eSpark-Backup/flst/Deliverables/Renderings/3D_Top_view.PNG

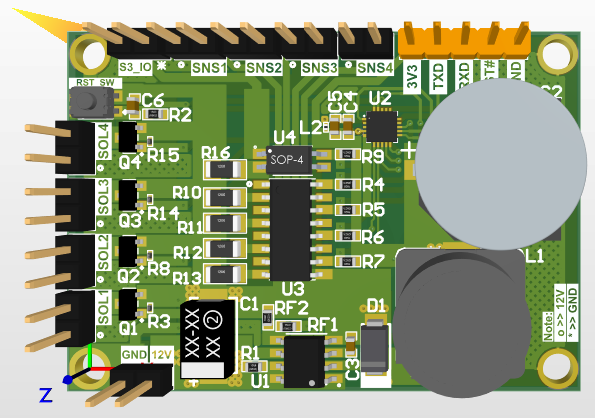
Deliverables/Renderings/3D_Top_view.PNG
