eSpark-Backup/flst/Deliverables/Renderings/3D_Bottom_view.PNG

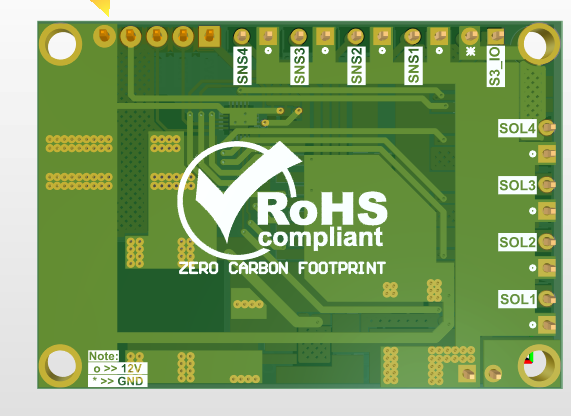
Deliverables/Renderings/3D_Bottom_view.PNG
