eSpark-Backup/flst/Design-Files/Junction_Box.html

Altium customize

# Board Information Report

Date: | | 2/23/2023
Time: | | 10:07:56 PM
Elapsed Time: | | 00:00:00
Filename: | | C:\Users\XPENDER\Documents\GitHub\flst\Design-Files\Junction_Box.PcbDoc
Units: | | mmmils

## Contents

Contents

Board Specification

General

Routing

Routing Information

Layer Information

Layer Information

Drill Pairs

Board Holes

Non-Plated Hole Size

Plated Hole Size

## Board Specification

General
Board Size | 2005mils x 1405mils
Components on board | 47

Back to top

## Routing

Routing Information
Routing completion | 100.00%
Connections | 107
Connections routed | 107
Connections remaining | 0

Back to top

## Layer Information

Layer | Arcs | Pads | Vias | Tracks | Texts | Fills | Regions | ComponentBodies
Top Layer | 0 | 119 | 0 | 140 | 0 | 48 | 0 | 0
Bottom Layer | 0 | 0 | 0 | 53 | 0 | 14 | 0 | 0
Dimension | 0 | 0 | 0 | 16 | 2 | 0 | 0 | 47
Board Outline | 0 | 0 | 0 | 4 | 0 | 0 | 0 | 0
Multi-Layer | 0 | 29 | 38 | 0 | 0 | 0 | 1 | 0
Top Paste | 0 | 0 | 0 | 0 | 0 | 0 | 0 | 0
Top Overlay | 21 | 0 | 0 | 211 | 111 | 3 | 0 | 0
Top Solder | 0 | 0 | 0 | 0 | 0 | 0 | 0 | 0
Bottom Solder | 0 | 0 | 0 | 0 | 0 | 0 | 0 | 0
Bottom Overlay | 0 | 0 | 0 | 0 | 16 | 0 | 0 | 0
Bottom Paste | 0 | 0 | 0 | 0 | 0 | 0 | 0 | 0
Drill Guide | 0 | 0 | 0 | 0 | 0 | 0 | 0 | 0
Keep-Out Layer | 0 | 0 | 0 | 0 | 0 | 0 | 0 | 0
Drill Drawing | 0 | 0 | 0 | 0 | 0 | 0 | 0 | 0
Total | 21 | 148 | 38 | 424 | 129 | 65 | 1 | 47

Back to top

Drill Pairs | Vias
Total | 0

Back to top

## Board Holes

Non-Plated Hole Size | Pads | Vias
0mils | 0 | 0
Total | 0 | 0

Back to top

Plated Hole Size | Pads | Vias
0mils | 0 | 0
11.811mils | 0 | 0
35.433mils | 0 | 0
40.158mils | 0 | 0
118.11mils | 0 | 0
Total | 0 | 0

Back to top
