eSpark-Backup/flst/Deliverables/Renderings/2D_Bottom_view.PNG

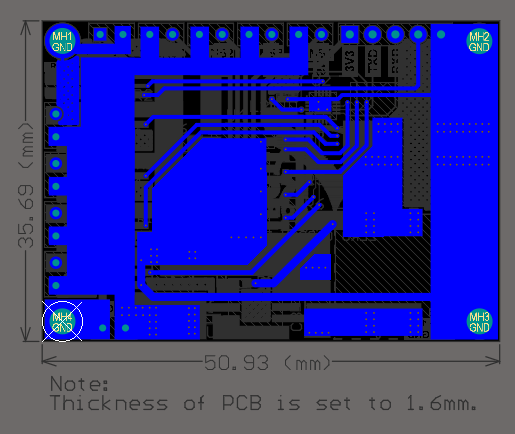
Deliverables/Renderings/2D_Bottom_view.PNG
