eSpark-Backup/flst/Deliverables/Renderings/2D_Top_view.PNG

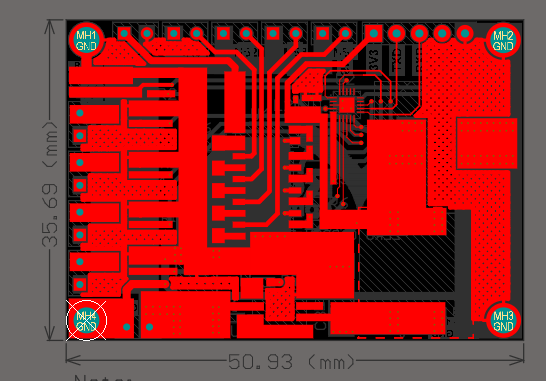
Deliverables/Renderings/2D_Top_view.PNG
