eSpark-Backup/flst/Deliverables/Renderings/3D_Isometric_view.PNG

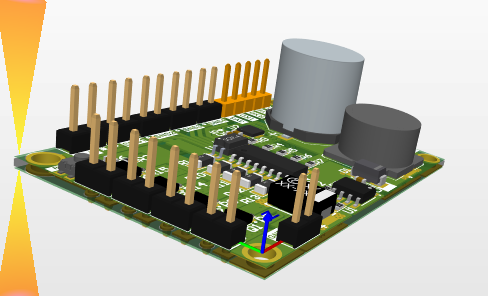
Deliverables/Renderings/3D_Isometric_view.PNG
