eSpark-Backup/flst/PCB Review/Layer Stackup.PNG

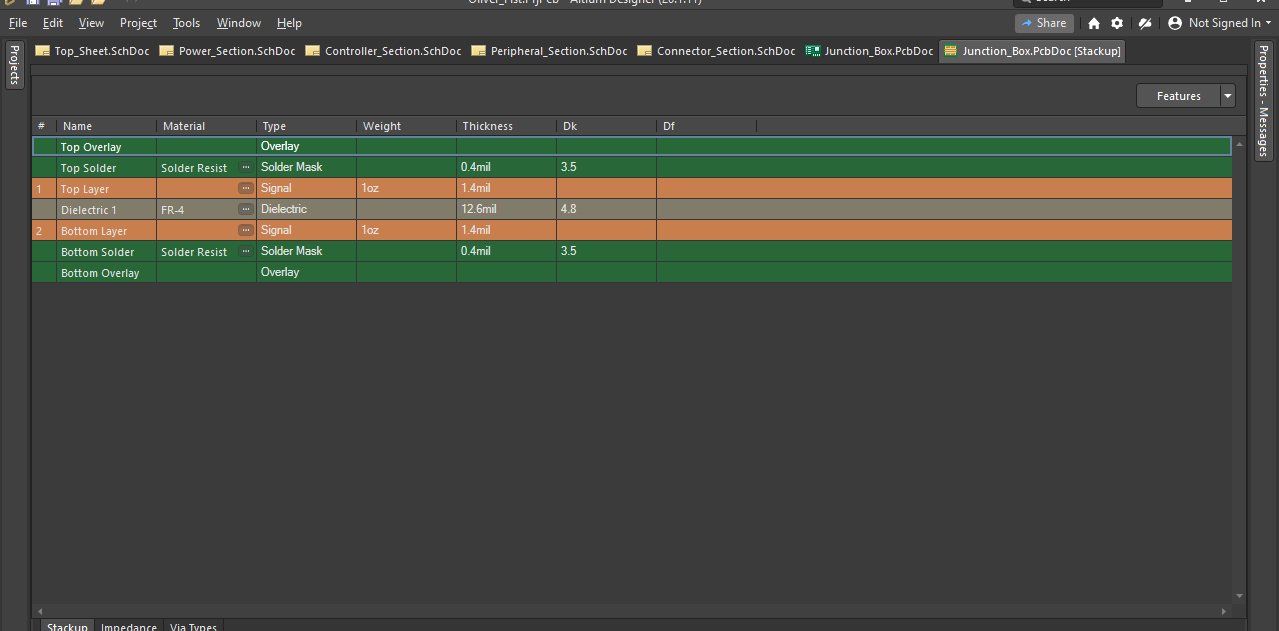
PCB Review/Layer Stackup.PNG
