eSpark-Backup/flst/Deliverables/BOM/eSpark_BOM_Oliver_Flst.xlsx

 |  | Component list |  | Bill of Materials for Project [Oliver_Flst]
 |  | Source Data From: |  | [Oliver_Flst]
 |  | Project: |  | [Oliver_Flst]
 |  | Variant: |  | None
# | Item Type | Designator | Description | Footprint | Manufacturer Part Number | Manufacturer | Alternate Part Number | LCSC/Part Number | Value | Quantity | Quantity (5 Boards) | MOQ (5 Boards) | Links | Unit Cost (5 Boards) | Total Cost (5 Boards) | Remarks | Reviewer Remarks
1 | Capacitor | C1 | CAP TANT 100UF 20% 25V 2917 | CAP- 2917 | TAJE107M025RNJ | Kyocera AVX | ----------- | C7230 | 100uF | 1 | 5 | 6 | LCSC (https://lcsc.com/product-detail/Tantalum-Capacitors_AVX-TAJE107M025RNJ_C7230.html) | $1.4064 | $8.44
2 | Capacitor | C2 | 470uF ±20% 50V 12.5mm 13.5mm 1000hrs 105℃ -40℃~+105℃ SMD,12.5x13.5mm Aluminum Electrolytic Capacitors - SMD RoHS | Custom | VKMD1001J101MV | Changzhou Huawei Elec | ----------- | C191227 | 470uF | 1 | 5 | 6 | LCSC (https://lcsc.com/product-detail/Aluminum-Electrolytic-Capacitors-SMD_Changzhou-Huawei-Elec-VT1H471MI135000CE0_C191227.html) | $0.3739 | $2.24
3 | Capacitor | C3 | CAP CER 470pF 10% X7R 50V 0603 SMD | Cap0603 | CC0603KRX7R9BB471 | Yageo | ----------- | C107092 | 470pF | 1 | 5 | 100 | LCSC (https://lcsc.com/product-detail/Multilayer-Ceramic-Capacitors-MLCC-SMD-SMT_YAGEO-CC0603KRX7R9BB471_C107092.html) | $0.0026 | $0.26
4 | Capacitor | C4, C6 | CAP CER 0.1UF 50V Y5V 0603 | Cap0603 | CC0603ZRY5V9BB104 | Yageo | ----------- | C106221 | 0.1uF | 2 | 10 | 100 | LCSC (https://lcsc.com/product-detail/Multilayer-Ceramic-Capacitors-MLCC-SMD-SMT_YAGEO-CC0603ZRY5V9BB104_C106221.html) | $0.0028 | $0.28
5 | Capacitor | C5 | CAP CER 1UF 25V X5R 0603 | Cap0603 | CC0603KRX5R8BB105 | Yageo | ----------- | C14664 | 1uF | 1 | 5 | 100 | LCSC (https://lcsc.com/product-detail/Multilayer-Ceramic-Capacitors-MLCC-SMD-SMT_YAGEO-CC0603KRX5R8BB105_C14664.html) | $0.0051 | $0.51
6 | Diode | D1 | 40V 500mV@2A 2A SMA(DO-214AC) Schottky Barrier Diodes (SBD) ROHS | SMA | SS24A | Yangzhou | ----------- | C211773 | -------- | 1 | 5 | 10 | LCSC (https://lcsc.com/product-detail/Schottky-Barrier-Diodes-SBD_Yangzhou-Yangjie-Elec-Tech-SS24A_C211773.html) | $0.0399 | $0.40
7 | Header | J1 | Pin Header 5 1 right-angle | HDR1X5 | PZ254V-11-05P | XFCN | ----------- | C492404 | ------- | 1 | 5 | 20 | LCSC (https://lcsc.com/product-detail/Pin-Headers_XFCN-PZ254V-11-05P_C492404.html) | $0.0261 | $0.52
8 | Inductor | L1 | Inductor Power Shielded Wirewound 220uH 20% 1KHz Ferrite 1.3A 310mOhm DCR Blister T/R | Custom | SLF12575T-221M1R3-PF | TDK | ----------- | C93225 | 220uH | 1 | 5 | 6 | LCSC (https://lcsc.com/product-detail/Power-Inductors_TDK-SLF12575T-221M1R3-PF_C93225.html) | $0.5091 | $3.05
9 | Inductor | L2 | FERRITE BEAD 600 OHM 0201 1LN | IND 0201 | MMZ0603S601CT000 | TDK | ----------- | C275404 | ------- | 1 | 5 | 50 | LCSC (https://lcsc.com/product-detail/Ferrite-Beads_TDK-MMZ0603S601CT000_C275404.html) | $0.0040 | $0.20
10 | Header | P1, P2, P3, P4, P5, P6, P7, P8, P9, P10 | CONN HEADER VERT 2POS 2.54MM | HDR1X2 | ~~61300211121~~ | Wurth Electronics | 210-91-02GB01 | C390678 | ------- | 10 | 50 | 50 | LCSC (https://lcsc.com/product-detail/Pin-Headers_PINREX-210-91-02GB01_C390678.html) | $0.0178 | $0.89
11 | Mosfet | Q1, Q2, Q3, Q4 | MOSFET N-CH 130V 1A SOT23 | SOT23-3 | DMN13H750S-7 | Diodes | ----------- | C156273 |  | 4 | 20 | 21 | LCSC (https://lcsc.com/product-detail/MOSFETs_Diodes-Incorporated-DMN13H750S-7_C156273.html) | $0.3405 | $7.15
12 | Resistor | R1 | 0.33Ω 0603 Chip Resistor - Surface Mount ROHS | RES-0603 | RTT03R330FTP | RALEC | ----------- | C103893 | 0.33R | 1 | 5 | 100 | LCSC (https://lcsc.com/product-detail/Chip-Resistor-Surface-Mount_RALEC-RTT03R330FTP_C103893.html) | $0.0038 | $0.38
13 | Resistor | R2 | RES SMD 4.7K OHM 1% 1/10W 0603 | RES-0603 | RC0603FR-074K7L | Yageo | ----------- | C99782 | 4.7K | 1 | 5 | 100 | LCSC (https://lcsc.com/product-detail/Chip-Resistor-Surface-Mount_YAGEO-RC0603FR-074K7L_C99782.html) | $0.0013 | $0.13
14 | Resistor | R3, R8, R14, R15 | RES SMD 10K OHM 1% 1/20W 0201 | Res-0201 | RC0201FR-0710KL | Yageo | ----------- | C106225 | 10K | 4 | 20 | 100 | LCSC (https://lcsc.com/product-detail/Chip-Resistor-Surface-Mount_YAGEO-RC0201FR-0710KL_C106225.html) | $0.0010 | $0.10
15 | Resistor | R4, R5, R6, R7, R9 | RES SMD 3.3K OHM 1% 1/10W 0603 | RES-0603 | RC0603FR-073K3L | Yageo Phycomp | ----------- | C108078 | 3.3K | 5 | 25 | 100 | LCSC (https://lcsc.com/product-detail/Chip-Resistor-Surface-Mount_YAGEO-RC0603FR-073K3L_C108078.html) | $0.0012 | $0.12
16 | Resistor | R10, R11, R12, R13, R16 | Chip Resistor Automotive Grade Thick Film 1206 536Ohm 1% Paper T/R, RES SMD 1206 536Ohm 1% Paper T/R | RES-1206 | AC1206FR-07536RL | Yageo | ----------- | C229696 | 536R | 5 | 25 | 50 | LCSC (https://lcsc.com/product-detail/Chip-Resistor-Surface-Mount_YAGEO-AC1206FR-07536RL_C229696.html) | $0.0031 | $0.15
17 | Resistor | RF1 | RES SMD 2K OHM 1% 1/10W 0603 | RES-0603 | RC0603FR-072KL | Yageo | ----------- | C105576 | 2K | 1 | 5 | 100 | LCSC (https://lcsc.com/product-detail/Chip-Resistor-Surface-Mount_YAGEO-RC0603FR-072KL_C105576.html) | $0.0012 | $0.12
18 | Resistor | RF2 | ±1% 1/10W Thick Film Resistors 75V ±100ppm/℃ -55℃~+155℃ 1.2kΩ 0603 Chip Resistor - Surface Mount ROHS | RES-0603 | 0603WAF1201T5E | UNI-ROYAL | ----------- | C22765 | 1.2K | 1 | 5 | 100 | LCSC (https://lcsc.com/product-detail/Chip-Resistor-Surface-Mount_UNI-ROYAL-Uniroyal-Elec-0603WAF1201T5E_C22765.html) | $0.0010 | $0.10
19 | Switch | SW1 | 3mm 2mm Round Button 50mA Top3.65mm SPST 12V SMD Tactile Switches | Custom | TS-1185EC-C-D-B | XKB | ----------- | C318893 | -------- | 1 | 5 | 10 | LCSC (https://lcsc.com/product-detail/Tactile-Switches_XKB-Connectivity-TS-1185EC-C-D-B_C318893.html) | $0.0563 | $0.56
20 | IC | U1 | 1.5-A boost, buck, inverting switching regulator, operation from 0°C to 70°C 8-SOIC 0 to 70 | SOIC-8 | MC34063ADR | Texas Instruments | ----------- | C100023 | -------- | 1 | 5 | 10 | LCSC (https://lcsc.com/product-detail/DC-DC-Converters_Texas-Instruments-MC34063ADR_C100023.html) | $0.3637 | $3.64
21 | IC | U2 | IC MCU 8BIT 16KB FLASH 20VQFN | 20-QFN | ATTINY1616-MNR | Microchip | ----------- | C507118 | -------- | 1 | 5 | 6 | LCSC (https://lcsc.com/product-detail/MICROCHIP_Microchip-Tech-ATTINY1616-MNR_C507118.html) | $1.1296 | $6.78
22 | IC | U3 | OPTOISO 3.75KV 4CH TRANS 16SO | 16SO | LTV-247 | Vishay Lite-On | ----------- | C115451 | -------- | 1 | 5 | 6 | LCSC (https://lcsc.com/product-detail/Optocouplers-Phototransistor-Output_Lite-On-LTV-247_C115451.html) | $0.4789 | $2.87
23 | IC | U4 | TransistorOptocouplers DC 1 2500Vrms SOP-4_P1.27 Optocouplers RoHS | SOP-4 | PS2801C-1-F3-A | CEL | ----------- | C67112 | -------- | 1 | 5 | 10 | LCSC (https://lcsc.com/product-detail/Optocouplers-Phototransistor-Output_RENESAS-PS2801C-1-F3-A_C67112.html) | $0.4151 | $4.15
 |  |  |  |  |  |  |  |  |  |  |  | Total Component Cost |  |  | $43.05
 |  |  |  |  |  |  |  |  |  |  |  | Single Board Cost |  |  | $8.61
