eSpark-Backup/flst/Deliverables/BOM/Client_BOM_Oliver_Flst.xlsx

 |  | Component list |  | Bill of Materials for Project [Oliver_Flst]
 |  | Source Data From: |  | [Oliver_Flst]
 |  | Project: |  | [Oliver_Flst]
 |  | Variant: |  | None
# | Item Type | Designator | Description | Footprint | Manufacturer Part Number | Manufacturer | Alternate Part Number | Value | Quantity | Quantity (5 Boards) | MOQ (5 Boards) | Unit Cost (5 Boards) | Total Cost (5 Boards) | Remarks | Reviewer Remarks
1 | Capacitor | C1 | CAP TANT 100UF 20% 25V 2917 | CAP- 2917 | TAJE107M025RNJ | Kyocera AVX | ----------- | 100uF | 1 | 5 | 7 | $1.0179 | $1.0179
2 | Capacitor | C2 | 470uF ±20% 50V 12.5mm 13.5mm 1000hrs 105℃ -40℃~+105℃ SMD,12.5x13.5mm Aluminum Electrolytic Capacitors - SMD RoHS | Custom | VKMD1001J101MV | Changzhou Huawei Elec | ----------- | 470uF | 1 | 5 | 7 | $0.5328 | $0.5328
3 | Capacitor | C3 | CAP CER 470pF 10% X7R 50V 0603 SMD | Cap0603 | CC0603KRX7R9BB471 | Yageo | ----------- | 470pF | 1 | 5 | 100 | $0.1034 | $0.1034
4 | Capacitor | C4, C6 | CAP CER 0.1UF 50V Y5V 0603 | Cap0603 | CC0603ZRY5V9BB104 | Yageo | ----------- | 0.1uF | 2 | 10 | 100 | $0.1033 | $0.1033
5 | Capacitor | C5 | CAP CER 1UF 25V X5R 0603 | Cap0603 | CC0603KRX5R8BB105 | Yageo | ----------- | 1uF | 1 | 5 | 50 | $0.1071 | $0.1071
6 | Diode | D1 | 40V 500mV@2A 2A SMA(DO-214AC) Schottky Barrier Diodes (SBD) ROHS | SMA | SS24A | Yangzhou | ----------- | -------- | 1 | 5 | 10 | $0.1406 | $0.1406
7 | Header | J1 | Pin Header 5 1 right-angle | HDR1X5 | PZ254V-11-05P | XFCN | ----------- | ------- | 1 | 5 | 20 | $0.1314 | $0.1314
8 | Inductor | L1 | Inductor Power Shielded Wirewound 220uH 20% 1KHz Ferrite 1.3A 310mOhm DCR Blister T/R | Custom | SLF12575T-221M1R3-PF | TDK | ----------- | 220uH | 1 | 5 | 7 | $0.5328 | $0.5328
9 | Inductor | L2 | FERRITE BEAD 600 OHM 0201 1LN | IND 0201 | MMZ0603S601CT000 | TDK | ----------- | ------- | 1 | 5 | 50 | $0.1156 | $0.1156
10 | Header | P1, P2, P3, P4, P5, P6, P7, P8, P9, P10 | CONN HEADER VERT 2POS 2.54MM | HDR1X2 | ~~61300211121~~ | Wurth Electronics | 210-91-02GB01 | ------- | 10 | 50 | 100 | $0.1090 | $0.1090
11 | Mosfet | Q1, Q2, Q3, Q4 | MOSFET N-CH 130V 1A SOT23 | SOT23-3 | DMN13H750S-7 | Diodes | ----------- |  | 4 | 20 | 22 | $0.4644 | $0.4644
12 | Resistor | R1 | 0.33Ω 0603 Chip Resistor - Surface Mount ROHS | RES-0603 | RTT03R330FTP | RALEC | ----------- | 0.33R | 1 | 5 | 50 | $0.1043 | $0.1043
13 | Resistor | R2 | RES SMD 4.7K OHM 1% 1/10W 0603 | RES-0603 | RC0603FR-074K7L | Yageo | ----------- | 4.7K | 1 | 5 | 100 | $0.1015 | $0.1015
14 | Resistor | R3, R8, R14, R15 | RES SMD 10K OHM 1% 1/20W 0201 | Res-0201 | RC0201FR-0710KL | Yageo | ----------- | 10K | 4 | 20 | 100 | $0.1012 | $0.1012
15 | Resistor | R4, R5, R6, R7, R9 | RES SMD 3.3K OHM 1% 1/10W 0603 | RES-0603 | RC0603FR-073K3L | Yageo Phycomp | ----------- | 3.3K | 5 | 25 | 100 | $0.1017 | $0.1017
16 | Resistor | R10, R11, R12, R13, R16 | Chip Resistor Automotive Grade Thick Film 1206 536Ohm 1% Paper T/R, RES SMD 1206 536Ohm 1% Paper T/R | RES-1206 | AC1206FR-07536RL | Yageo | ----------- | 536R | 5 | 25 | 50 | $0.1013 | $0.1013
17 | Resistor | RF1 | RES SMD 2K OHM 1% 1/10W 0603 | RES-0603 | RC0603FR-072KL | Yageo | ----------- | 2K | 1 | 5 | 100 | $0.1015 | $0.1015
18 | Resistor | RF2 | ±1% 1/10W Thick Film Resistors 75V ±100ppm/℃ -55℃~+155℃ 1.2kΩ 0603 Chip Resistor - Surface Mount ROHS | RES-0603 | 0603WAF1201T5E | UNI-ROYAL | ----------- | 1.2K | 1 | 5 | 100 | $0.1013 | $0.1013
19 | Switch | SW1 | 3mm 2mm Round Button 50mA Top3.65mm SPST 12V SMD Tactile Switches | Custom | TS-1185EC-C-D-B | XKB | ----------- | -------- | 1 | 5 | 10 | $0.1591 | $0.1591
20 | IC | U1 | 1.5-A boost, buck, inverting switching regulator, operation from 0°C to 70°C 8-SOIC 0 to 70 | SOIC-8 | MC34063ADR | Texas Instruments | ----------- | -------- | 1 | 5 | 6 | $0.5941 | $0.5941
21 | IC | U2 | IC MCU 8BIT 16KB FLASH 20VQFN | 20-QFN | ATTINY1616-MNR | Microchip | ----------- | -------- | 1 | 5 | 6 | $2.0494 | $2.0494
22 | IC | U3 | OPTOISO 3.75KV 4CH TRANS 16SO | 16SO | LTV-247 | Vishay Lite-On | ----------- | -------- | 1 | 5 | 6 | $1.0468 | $1.0468
23 | IC | U4 | TransistorOptocouplers DC 1 2500Vrms SOP-4_P1.27 Optocouplers RoHS | SOP-4 | PS2801C-1-F3-A | CEL | ----------- | -------- | 1 | 5 | 6 | $0.6428 | $0.6428
 |  |  |  |  |  |  |  |  |  |  | Total Component Cost |  | $8.56
 |  |  |  |  |  |  |  |  |  |  | Single Board Cost |  | $1.71
