eSpark-Backup/flst/Deliverables/Supporting Files/Junction_Box.step

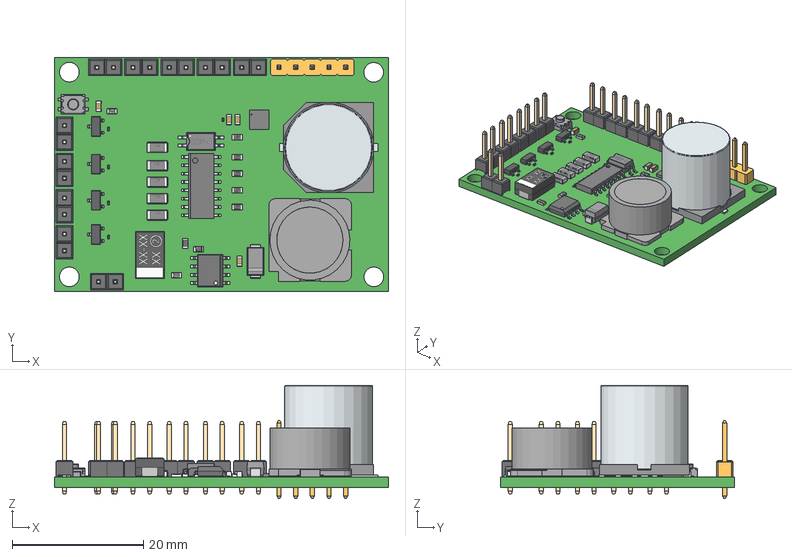
[picture p8: CAD file, 2023-02-24]
Deliverables/Supporting Files/Junction_Box.step
50.9 x 35.7 x 17.3 mm
User_Library-DO-214AC_SMA
User_Library-0201(0603M)_Res x 4
Base
Pin1Fillet
Pin2Fillet
User_Library-SOP-4-1
User_Library-SOIC-16-1
VQFN20_3X3_MCH
User_Library-SO-8N__X2_041A043E0440043F04430441_X0_
User_Library-SO-8N__X2_041C04350442043A0430_X0_
User_Library-SO-8N__X2_041D043E0436043A0430_X0_ x 4
ts-1185ec-c-d-b_RGB6710886
User_Library-RESC1608X05N x 9
User_Library-1206_SMD_Resistor x 5
CircuitWorks-SOT-23 x 4
User_Library-Header1x2_Header1_1 x 20
Ferrite
slf12575_RGB6710886 x 5
User_Library-zl201-5_p2-54_l12-7_w2-54_h8-89
User_Library-CAPC1608X09 x 4
593D_D-CASE
