eSpark-Backup/flst/(list of files, cad)

Other CAD files:
Deliverables/Supporting Files/Junction_Box.DWG
Deliverables/Supporting Files/Junction_Box.DXF
