eSpark-Backup/flst/Documents/Client-Shared/New-Project.2.pdf

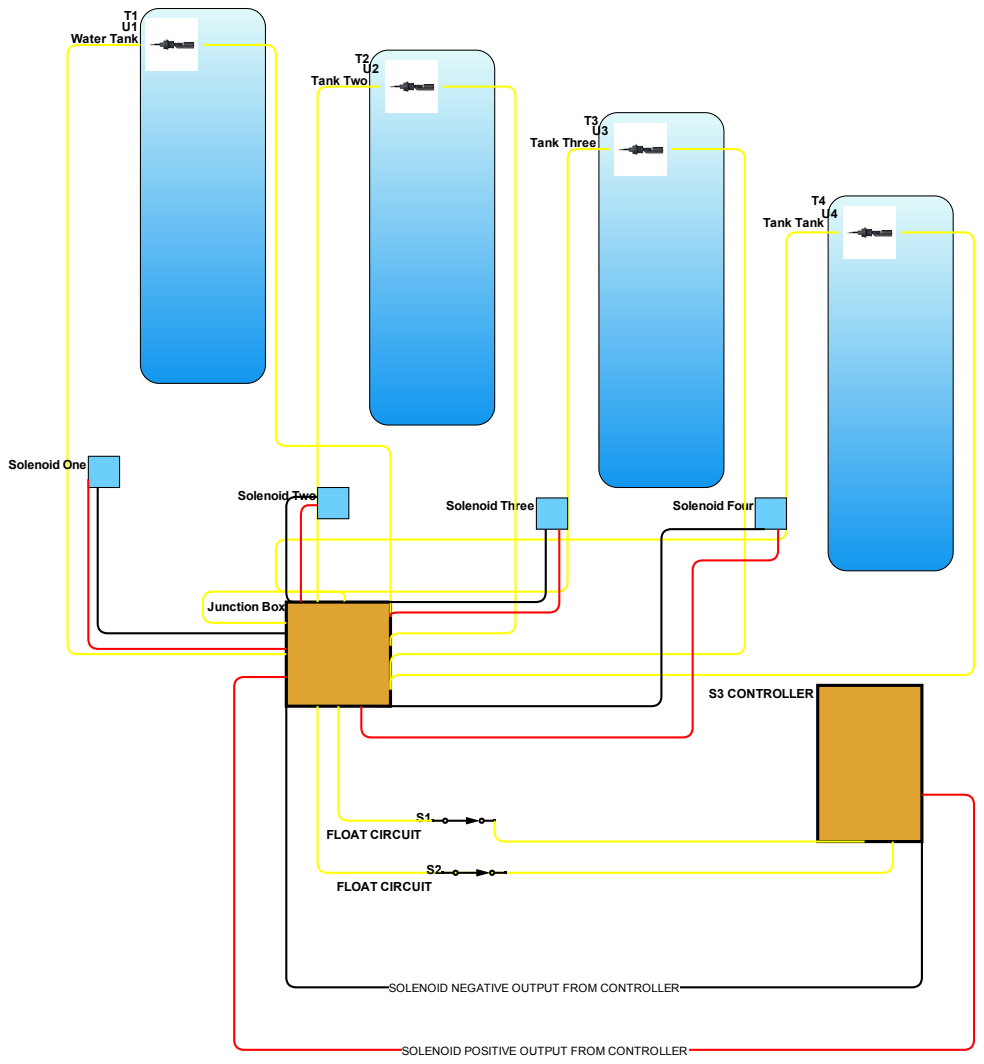
[picture p16: page 1]
Water Tank; Tank Three; Tank Two; Tank Tank; S3 CONTROLLER; S1 FLOAT CIRCUIT; Junction Box; Solenoid One; Solenoid Two; Solenoid Three; Solenoid Four; S2 FLOAT CIRCUIT

SOLENOID NEGATIVE OUTPUT FROM CONTROLLER

SOLENOID POSITIVE OUTPUT FROM CONTROLLER
