eSpark-Backup/flst/Deliverables/Schematic/Assembly_Drawing.pdf

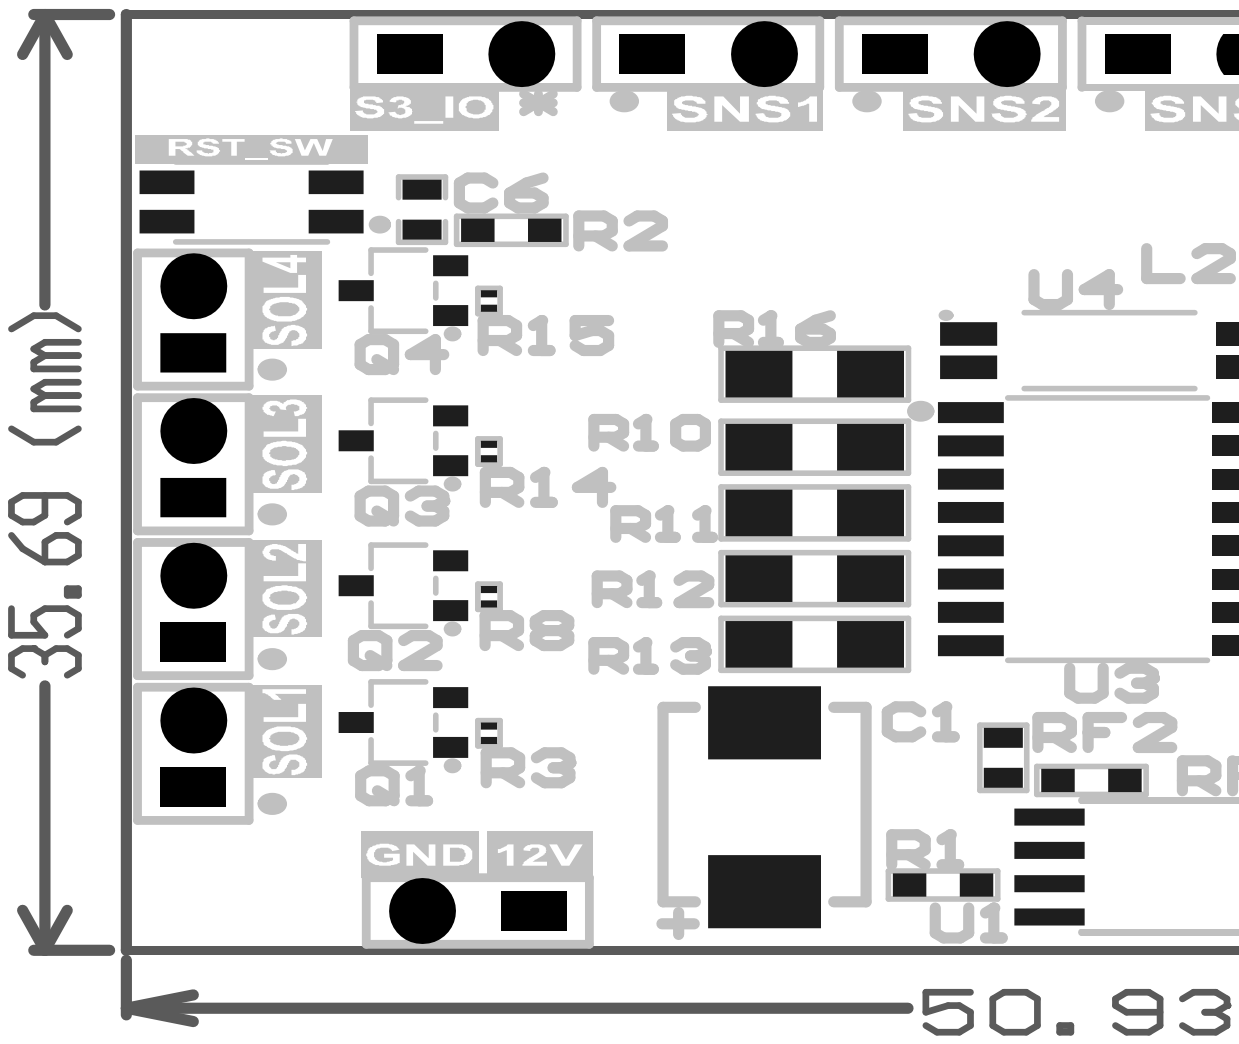
[picture p17: page 1]

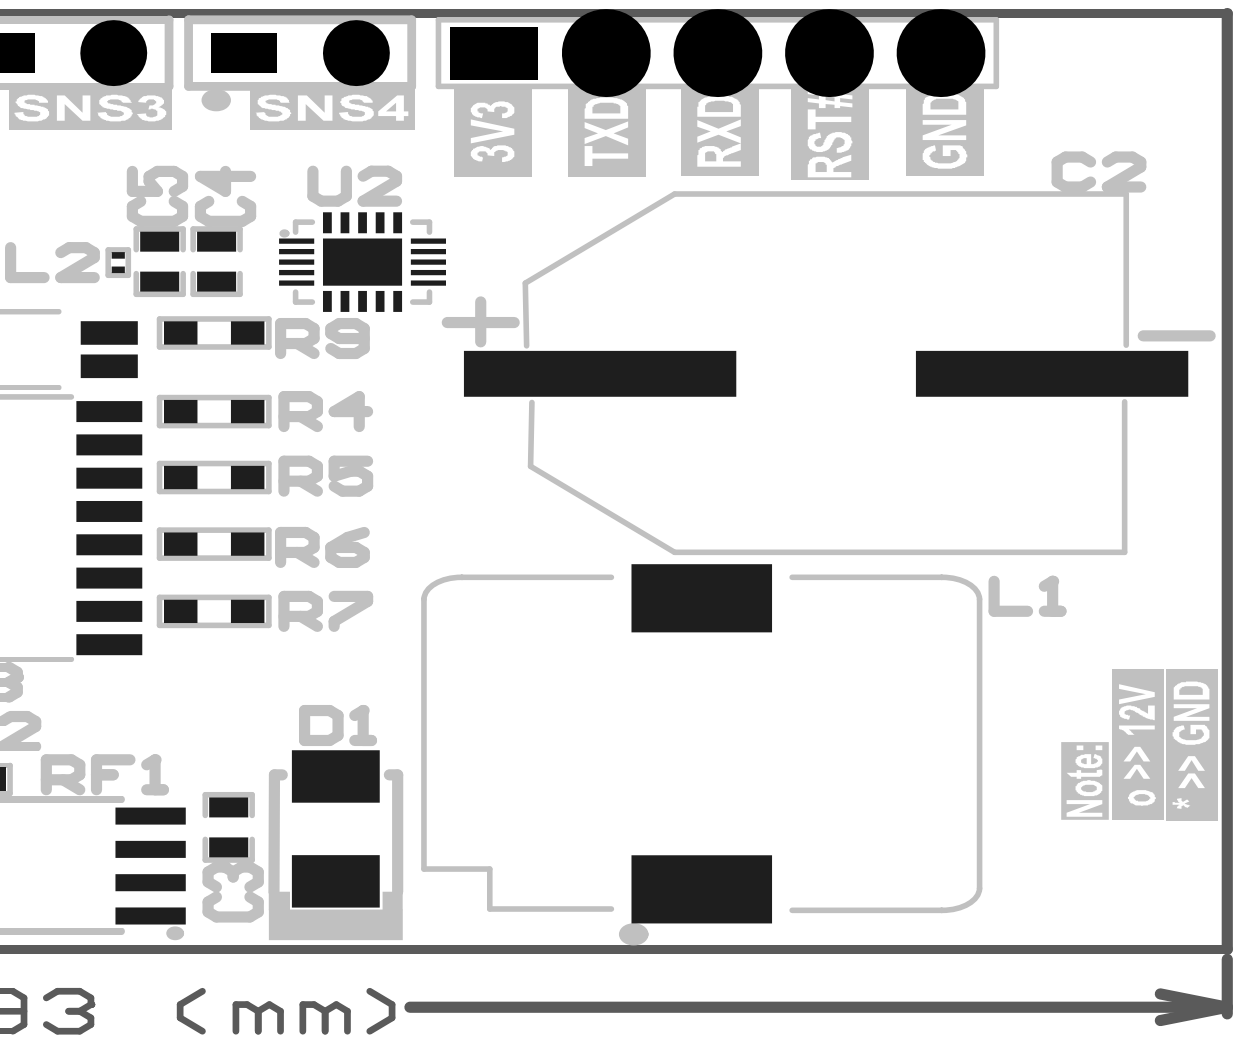
[picture p18: page 2]

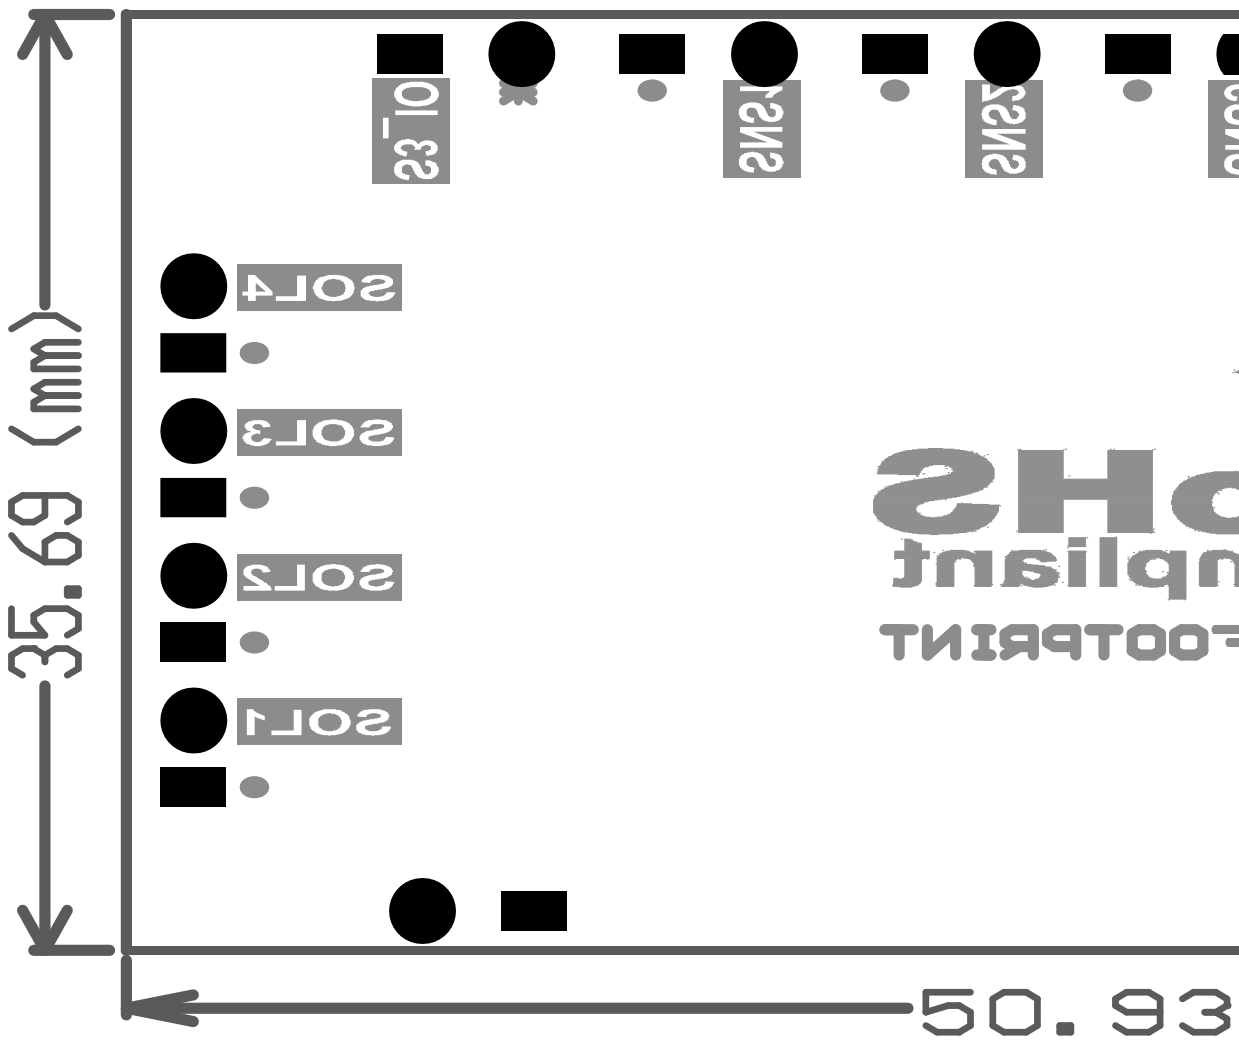
[picture p19: page 3]

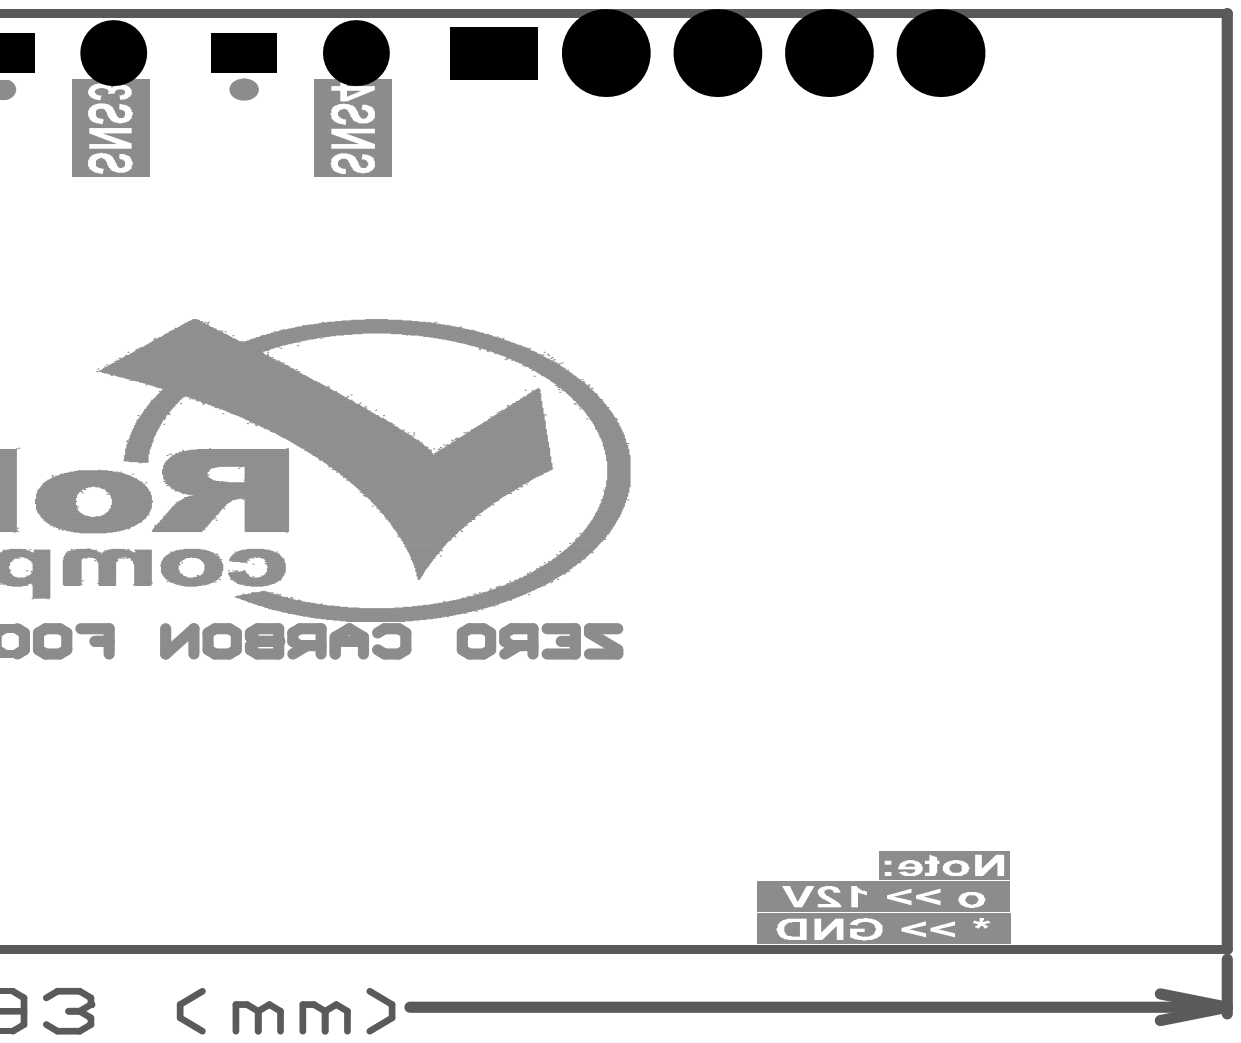
[picture p20: page 4]
