eSpark-Backup/flst/(list of files, drawings)

Other design files:
Design-Files/Connector_Section.SchDoc
Design-Files/Controller_Section.SchDoc
Design-Files/Junction_Box.PcbDoc
Design-Files/Oliver_Flst.PrjPcb
Design-Files/Peripheral_Section.SchDoc
Design-Files/Power_Section.SchDoc
Design-Files/Top_Sheet.SchDoc
Library-Files/Flst_PcbLib.PcbLib
Library-Files/Flst_Schlib.SchLib
