eSpark-Backup/flst/(commit log)

2022-03-09 Schematic design for controller and buck regulator #4
    [Controller_Section.SchDoc, Oliver_Flst.PrjPcb, Power_Section.SchDoc, Top_Sheet.SchDoc]
2022-03-09 Issue resolved #4
    [Connector_Section.SchDoc, Controller_Section.SchDoc, Oliver_Flst.PrjPcb, Power_Section.SchDoc, Top_Sheet.SchDoc]
2022-03-09 Schematic completed #5. Library and formatting pending
    [Connector_Section.SchDoc, Controller_Section.SchDoc, Oliver_Flst.PrjPcb, Peripheral_Section.SchDoc, Power_Section.SchDoc, Top_Sheet.SchDoc]
2022-03-10 Junction box sch and lib completed. PCB updated #5 #4 #3
    [Connector_Section.SchDoc, Controller_Section.SchDoc, Junction_Box.PcbDoc, Oliver_Flst.PrjPcb, Peripheral_Section.SchDoc, Power_Section.SchDoc, Top_Sheet.SchDoc]
2022-03-31 Parts placement completed #6 and Routing completed #7
    [Junction_Box.PcbDoc, Peripheral_Section.SchDoc]
2022-03-31 #8 in progress.
    [Oliver_Flst_Altium.xlsx]
2022-04-05 Minor changes in PCB. Refer to #10 for details.
    [Connector_Section.SchDoc, Controller_Section.SchDoc, Junction_Box.PcbDoc, Oliver_Flst.PrjPcb, Peripheral_Section.SchDoc, Power_Section.SchDoc, Top_Sheet.SchDoc]
2022-04-08 Deliverables generated #11
    [Connector_Section.SchDoc, Controller_Section.SchDoc, Junction_Box.DWG, Junction_Box.DXF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]
2022-05-26 Client BOM generated acc to #8
    [FLST_Digikey.xlsx, FLST_LCSC.xlsx, Junction_Box.PcbDoc, Oliver_Flst(Altium-Generated).xlsx, Oliver_Flst.PrjPcb, Oliver_Flst_Altium.xlsx]
2022-05-26 File name changed. Review pending #14
    [FLST_Client BOM.xlsx, FLST_LCSC.xlsx]
2022-05-26 Alternate added for header in client bom
    [FLST_Client BOM.xlsx]
2022-05-27 PCB Updated according to Library Review mention in #15 and fresh deliverables generated #11
    [Connector_Section.SchDoc, Junction_Box.DWG, Junction_Box.DXF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]
2022-05-27 #8 Completed
    [FLST_Client BOM.xlsx, FLST_Digikey.xlsx, Oliver_Flst(Altium-Generated).xlsx]
2022-05-30 BOM generated acc: #16
    [FLST_PCBWay BOM.xlsx]
2022-05-30 BOM updated #16
    [FLST_PCBWay BOM.xlsx]
2022-05-30 Total price divided by 5
    [FLST_Client BOM.xlsx]
2022-05-30 per board quantity formatted #14
    [FLST_Client BOM.xlsx]
2022-06-06 #18 completed. Notes added.
    [Connector_Section.SchDoc, Junction_Box.PcbDoc, Oliver_Flst.PrjPcb, Peripheral_Section.SchDoc, Power_Section.SchDoc]
2022-06-09 Added gitignore and removed History
    [Connector_Section.SchDoc, Controller_Section.SchDoc, Flst_PcbLib.PcbLib, Flst_Schlib.SchLib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]
2022-06-13 Resolved #13 Parts imported to PCB
    [Connector_Section.SchDoc, Junction_Box.PcbDoc, Power_Section.SchDoc]
2022-06-13 Diode Orientation fixed #13
    [Junction_Box.PcbDoc, Power_Section.SchDoc]
2022-06-14 PCB updated acc #13 and #19 Fresh Deliverables also generated
    [Junction_Box.DWG, Junction_Box.DXF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]
2022-06-14 #20 Completed
    [FLST_Client BOM.xlsx, FLST_LCSC_ BOM.xlsx, FLST_PCBWay BOM.xlsx]
2022-06-16 @Channel Old BOM Folder Deleted
    [FLST_Client BOM.xlsx, FLST_Digikey.xlsx, Oliver_Flst(Altium-Generated).xlsx]
2022-06-20 #16 Quantity Per Board Column Name updated.
    [FLST_PCBWay BOM.xlsx]
2022-10-31 #20 Updated Files.
    [Client_BOM_Oliver_Flst.xlsx, FLST_Client BOM.xlsx, FLST_eSpark_BOM.xlsx, eSpark_BOM_Oliver_Flst.xlsx]
2023-02-21 #20 #21 Completed.
    [Centroid File.csv, FLST_LCSC_BOM.xlsx, FLST_PCBWay BOM.xlsx, JLCPCB-BOM.xlsx, Pick Place for Junction_Box.csv, eSpark_BOM_Oliver_Flst.xlsx]
2023-02-23 #22 Routing in Progress
    [Controller_Section.SchDoc, Junction_Box.PcbDoc, Oliver_Flst.PrjPcb, Power_Section.SchDoc]
2023-02-23 #22 Done.
    [Connector_Section.SchDoc, Controller_Section.SchDoc, Junction_Box.PcbDoc, Oliver_Flst.PrjPcb, Peripheral_Section.SchDoc, Power_Section.SchDoc, Top_Sheet.SchDoc]
2023-02-24 #23 Fresh Deliverables generated
    [Centroid File.csv, Centroid_File.csv, Connector_Section.SchDoc, Controller_Section.SchDoc, Junction_Box.DWG, Junction_Box.DXF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]
2023-02-24 Schematic changes due to decoup cap issue #22
    [Controller_Section.SchDoc]
2023-02-24 project saved
    [Oliver_Flst.PrjPcb]
2023-02-24 #23 Changes Update And Fresh deliverables Generated
    [Centriod_Files.csv, Junction_Box.DWG, Junction_Box.DXF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]
2023-02-24 pcb changes in progress
    [Connector_Section.SchDoc, Controller_Section.SchDoc, Junction_Box.PcbDoc, Oliver_Flst.PrjPcb, Peripheral_Section.SchDoc, Power_Section.SchDoc, Top_Sheet.SchDoc]
2023-02-24 #23 Centroid And Gerber Created
    [Centroid File.csv, Connector_Section.SchDoc, Controller_Section.SchDoc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]
2023-02-24 #23 Fresh Gerbers Generated.
    [Centriod_Files.csv, Centroid File.csv, Connector_Section.SchDoc, Controller_Section.SchDoc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]
2023-05-31 #24 Arduino Code Added
